Makerfabs/ESP32-S3_Parallel_TFT_3.16_ST7701S/README.md

# ESP32-S3_Parallel_TFT_3.16_ST7701S

This routine how reads the data from the QMI8658 and detects the flip to control the image switching.

## Makerfabs

[Makerfabs home page](https://www.makerfabs.com/)

[Makerfabs Wiki](https://wiki.makerfabs.com/)

## Introduce

Product Link: 

Wiki Link: [https://wiki.makerfabs.com/ESP32-S3_Parallel_TFT_3.16_ST7701S.html](https://wiki.makerfabs.com/ESP32-S3_Parallel_TFT_3.16_ST7701S.html)

The Latest ESP32-S3 3.16 inch display with 320*820 resolution, it integrated display/audio speaker/IMU(QMI8658)/RTC, to make this product ideal for applications such as IoT controlling, electronic photo frame, etc.

## Feature

- Controller: ESP32-S3
- Wireless: WiFi& Bluetooth 5.0
- LCD: 2.8", 320x820 resolution
- LCD Driver: ST7701s
- Flash: 16MB Flash
- PSRAM: 8MB
- USB: 1 * USB to UART
- Power Supply: USB Type-C 5.0V(4.0V~5.25V)
- Button: Flash button and reset button
- MicroSD: Yes
- RTC: Yes
- IMU: Yes
- Microphone input: 1CH INMP441
- Audio output: MAX98357(3.2W@4Ω)
- LVGL support: Yes
