Makerfabs/ESP32-S3_Parallel_TFT_3.16_ST7701S/examples/esp-idf/weather/README.md

Set the current chip to ESP32-S3.



Modify WIFI information.



Automatically obtain location information based on IP addresses.

The serial port output is as follows:
