Makerfabs/ESP32-S3_Parallel_TFT_3.16_ST7701S/hardware/ESP32-S3 Parallel TFT 3.16“ ST7701S v1.0.PDF

POWER | RTC

# LCD

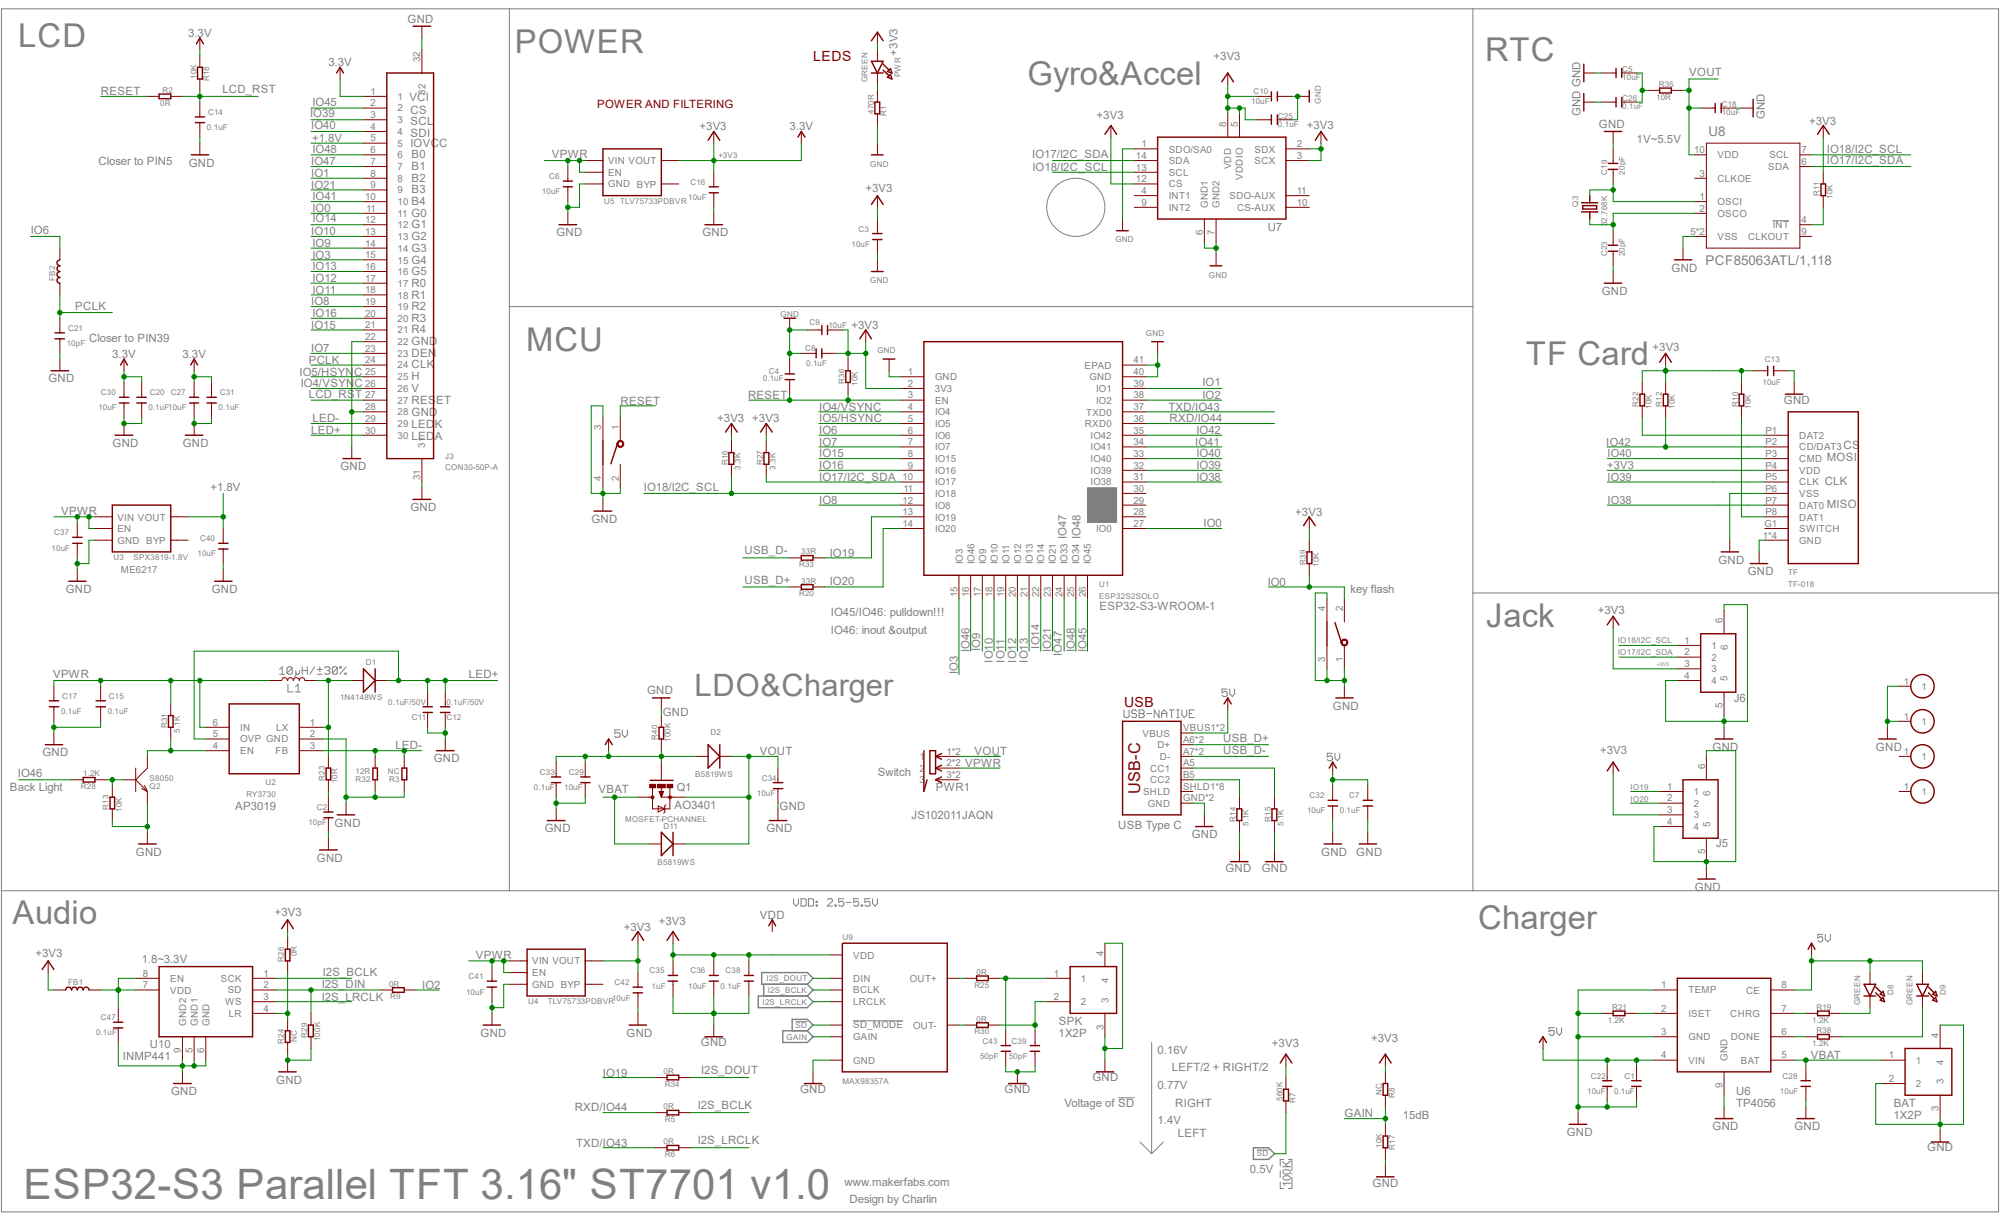
[picture p1: page 1]

www.makerfabs.com ESP32-S3 Parallel TFT 3.16" ST7701 v1.0 Design by Charlin
