Makerfabs/ESP32-S3_Parallel_TFT_3.16_ST7701S/hardware/ESP32-S3 Parallel TFT 3.16“ ST7701S v1.0.brd

## EAGLE design hardware/ESP32-S3 Parallel TFT 3.16“ ST7701S v1.0.brd (2025-10-23)

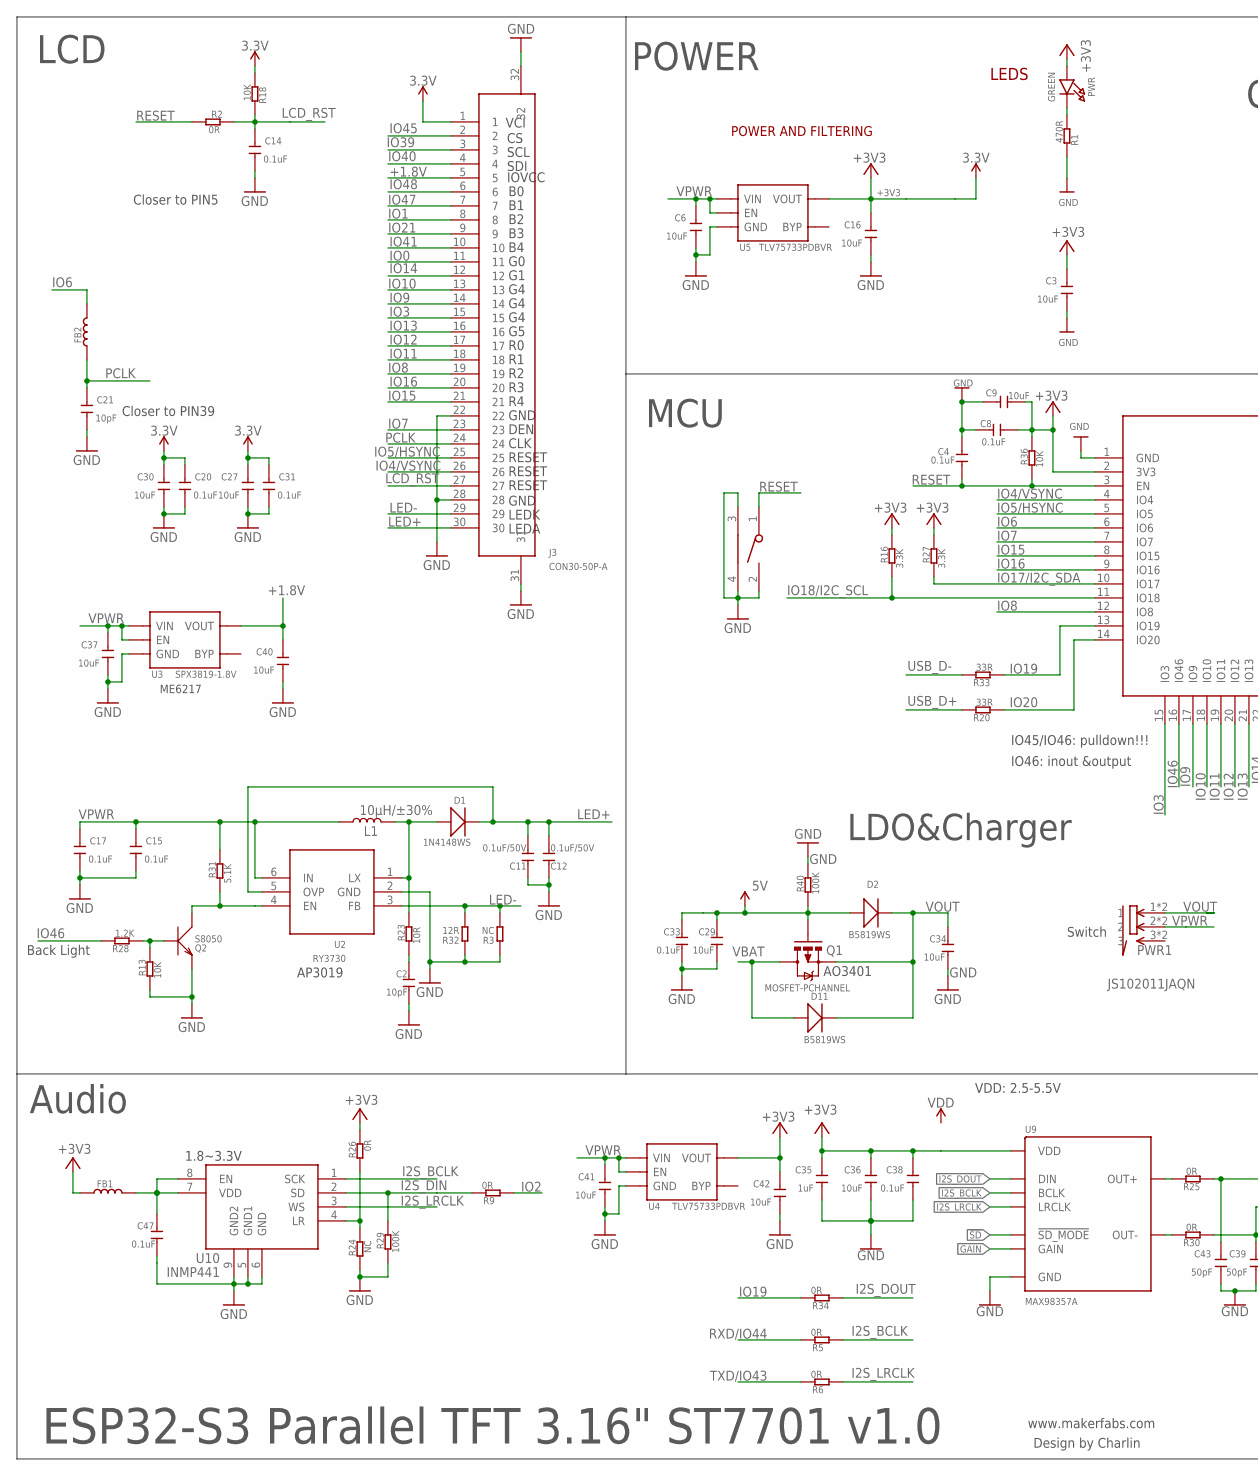
[picture p2: schematic ESP32-S3 Parallel TFT 3.16“ ST7701S v1.0.sch, part in row 1, column 1]

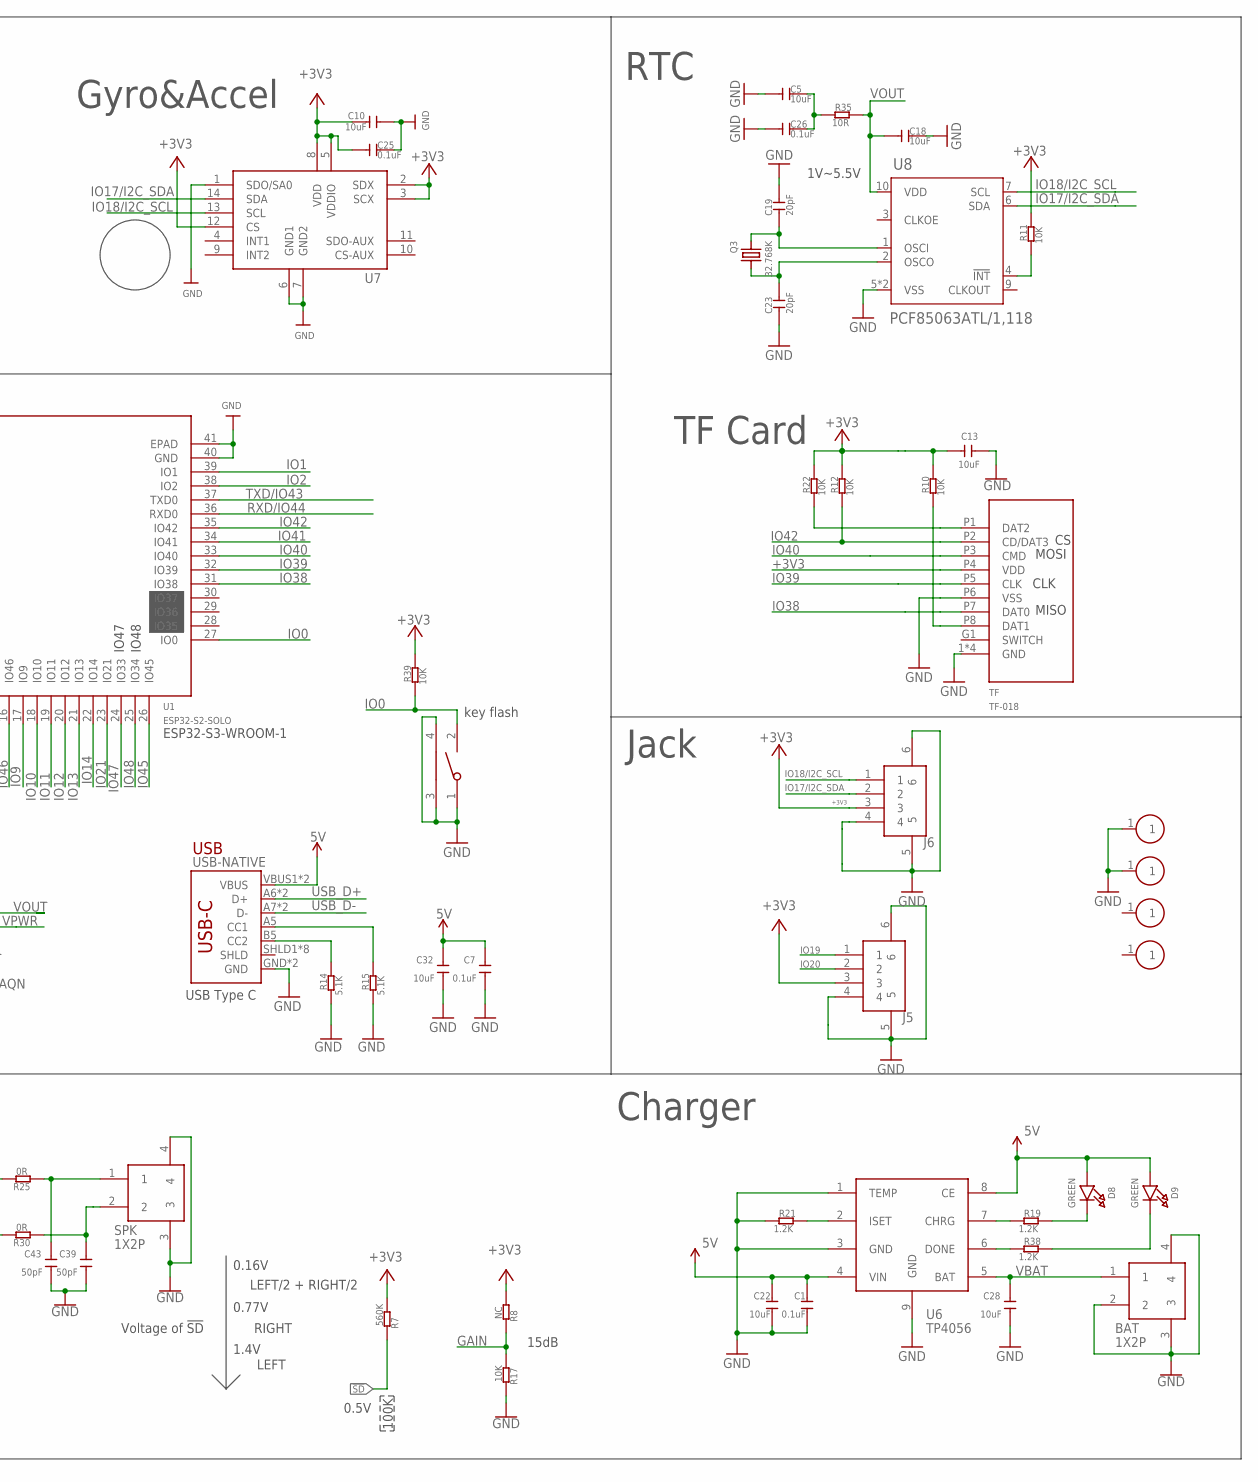
[picture p3: schematic ESP32-S3 Parallel TFT 3.16“ ST7701S v1.0.sch, part in row 1, column 2]

Parts:
BAT: 1X2P; 1X2P-SMT1.25MM
C1, C4, C7, C8, C14, C15, C17, C20, C25, C26, C31, C33, C38, C47: 0.1uF; DISCRETE_C0402
C2, C21: 10pF; DISCRETE_C0402
C3, C5, C6, C9, C10, C13, C16, C18, C22, C27, C28, C29, C30, C32, C34, C36, C37, C40, C41, C42: 10uF; DISCRETE_C0402
C11, C12: 0.1uF/50V; DISCRETE_C0603
C19, C23: 20pF; DISCRETE_C0402
C35: 1uF; DISCRETE_C0402
C39, C43: 50pF; DISCRETE_C0402
D1: 1N4148WS; SOD323
D2, D11: B5819WS; SOD323
D8, D9: GREEN; CHIPLED_0805_NOOUTLINE
FB1, FB2: L'0402'; 0402
FLASH: TS24CA; 2*4*3.5MM
J3: CON30-50P-A; SMD30-50P-1850L540W300H
J5, J6: CON4-100P-V; SMD4-100P-635L374W374H
L1: 10µH/±30%; CR54
PWR: GREEN; CHIPLED_0805_NOOUTLINE
PWR1: JS102011JAQN; SMD-6-2.5MM
Q1: MOSFET-PCHANNEL; SOT23-3
Q2: S8050; SOT23
Q3: 32.768K; XTAL3215
R1: 470R; DISCRETE_R0402
R2, R5, R6, R9, R25, R26, R30, R34: 0R; DISCRETE_R0402
R3: NC; DISCRETE_R0603
R7: 560K; DISCRETE_R0402
R8, R24: NC; DISCRETE_R0402
R10, R11, R12, R13, R17, R18, R22, R36, R39: 10K; DISCRETE_R0402
R14, R15, R31: 5.1K; DISCRETE_R0402
R16, R27: 3.3K; DISCRETE_R0402
R19, R21, R28, R38: 1.2K; DISCRETE_R0402
R20, R33: 33R; DISCRETE_R0402
R23, R35: 10R; DISCRETE_R0402
R29, R40: 100K; DISCRETE_R0402
R32: 12R; DISCRETE_R0603
RST: TS24CA; 2*4*3.5MM
S1, S2, S3, S4: CON1-A; THD1-210M-310D
SPK: 1X2P; 1X2P-SMT1.25MM
TF: TF-018
U1: ESP32­S2­SOLO; ESP32-­S2-­SOLO
U2: RY3730; SOT23-6
U3: SPX3819-1.8V; SOT23-5
U4, U5: TLV75733PDBVR; SOT23-5
U6: TP4056; SOP8-1.27P
U7: QMI8658A; LGA14-50P-300L250W86H
U8: PCF85063ATL/1,118; 10-DFN(2.6X2.6)
U9: MAX98357A; TQFN-16
U10: INMP441; SMD9-105P-472L376W98H
USB-NATIVE: USB_C5; USB-C-16P-5

Connections:
5V: C1.2, C7.2, C22.2, C29.2, C32.2, C33.2, D2.+, D8.A, D9.A, Q1.1 (G), R40.1, U6.4 (VIN), U6.8 (CE), USB-NATIVE.VBUS1 (VBUS), USB-NATIVE.VBUS2 (VBUS)
!SD: R7.2, U9.P$4 (!SD_MODE)
+1.8V: C40.2, J3.5, U3.5 (VOUT)
+3V3: C3.2, C8.1, C9.1, C10.2, C13.2, C16.2, C20.2, C25.2, C27.2, C30.2, C31.2, C35.2, C36.2, C38.2, C42.2, FB1.1, J3.1, J5.3, J6.3, PWR.A, R7.1, R8.1, R10.2, R11.2, R12.2, R16.2, R18.1, R22.2, R26.2, R27.2, R36.2, R39.2, TF.P4 (VDD), U1.2 (3V3), U4.5 (VOUT), U5.5 (VOUT), U7.2 (SDX), U7.3 (SCX), U7.5 (VDDIO), U7.8 (VDD), U7.12 (CS), U9.P$7 (VDD), U9.P$8 (VDD)
GAIN: R8.2, R17.1, U9.P$2 (GAIN)
GND: BAT.2, BAT.3, BAT.4, C1.1, C2.1, C3.1, C4.2, C5.2, C6.1, C7.1, C8.2, C9.2, C10.1, C11.1, C12.1, C13.1, C14.1, C15.1, C16.1, C17.1, C18.1, C19.1, C20.1, C21.1, C22.1, C23.2, C25.1, C26.2, C27.1, C28.1, C29.1, C30.1, C31.1, C32.1, C33.1, C34.1, C35.1, C36.1, C37.1, C38.1, C39.1, C40.1, C41.1, C42.1, C43.1, C47.1, FLASH.1, FLASH.3, FLASH.4, J3.22, J3.28, J3.31, J3.32, J5.4, J5.5, J5.6, J6.4, J6.5, J6.6, Q2.2 (E), R1.2, R3.1, R13.1, R14.1, R15.1, R17.2, R21.1, R24.1, R29.1, R32.1, R40.2, RST.2, RST.3, RST.4, S1.1, S2.1, SPK.3, SPK.4, TF.1 (GND), TF.2 (GND), TF.3 (GND), TF.4 (GND), TF.P6 (VSS), U1.1 (GND), U1.40 (GND), U1.41 (EPAD), U2.2 (GND), U3.2 (GND), U4.2 (GND), U5.2 (GND), U6.1 (TEMP), U6.3 (GND), U6.9 (GND), U7.1 (SDO/SA0), U7.6 (GND1), U7.7 (GND2), U8.5 (VSS), U8.11 (VSS), U9.P$3 (GND), U9.P$11 (GND), U9.P$15 (GND), U9.P$EP (GND), U10.5 (GND1), U10.6 (GND), U10.9 (GND2), USB-NATIVE.GND, USB-NATIVE.GND2 (GND)
I2S_BCLK: R5.1, U9.P$16 (BCLK), U10.1 (SCK)
I2S_DIN: R9.2, R29.2, U10.2 (SD)
I2S_DOUT: R34.1, U9.P$1 (DIN)
I2S_LRCLK: R6.1, U9.P$14 (LRCLK), U10.3 (WS)
IO0: FLASH.2, J3.11, R39.1, U1.27 (IO0)
IO1: J3.8, U1.39 (IO1)
IO2: R9.1, U1.38 (IO2)
IO3: J3.15, U1.15 (IO3)
IO4/VSYNC: J3.26, U1.4 (IO4)
IO5/HSYNC: J3.25, U1.5 (IO5)
IO6: FB2.2, U1.6 (IO6)
IO7: J3.23, U1.7 (IO7)
IO8: J3.19, U1.12 (IO8)
IO9: J3.14, U1.17 (IO9)
IO10: J3.13, U1.18 (IO10)
IO11: J3.18, U1.19 (IO11)
IO12: J3.17, U1.20 (IO12)
IO13: J3.16, U1.21 (IO13)
IO14: J3.12, U1.22 (IO14)
IO15: J3.21, U1.8 (IO15)
IO16: J3.20, U1.9 (IO16)
IO17/I2C_SDA: J6.2, R27.1, U1.10 (IO17), U7.14 (SDA), U8.6 (SDA)
IO18/I2C_SCL: J6.1, R16.1, U1.11 (IO18), U7.13 (SCL), U8.7 (SCL)
IO19: J5.1, R33.1, R34.2, U1.13 (IO19)
IO20: J5.2, R20.1, U1.14 (IO20)
IO21: J3.9, U1.23 (IO21)
IO38: TF.P7 (DAT0), U1.31 (IO38)
IO39: J3.3, TF.P5 (CLK), U1.32 (IO39)
IO40: J3.4, TF.P3 (CMD), U1.33 (IO40)
IO41: J3.10, U1.34 (IO41)
IO42: R12.1, TF.P2 (CD/DAT3), U1.35 (IO42)
IO45: J3.2, U1.26 (IO45)
IO46: R28.2, U1.16 (IO46)
IO47: J3.7, U1.24 (IO33)
IO48: J3.6, U1.25 (IO34)
LCD_RST: C14.2, J3.27, R2.2, R18.2
LED+: C11.2, C12.2, D1.-, J3.30, U2.5 (OVP)
LED-: J3.29, R3.2, R32.2, U2.3 (FB)
unnamed: R22.1, TF.P1 (DAT2)
unnamed: R10.1, TF.P8 (DAT1)
unnamed: C5.1, C26.1, R35.1
unnamed: C19.2, Q3.P$1 (1), U8.1 (OSCI)
unnamed: R30.2, U9.P$10 (OUT-)
unnamed: R15.2, USB-NATIVE.A5 (CC1)
unnamed: PWR.C, R1.1
unnamed: Q2.1 (B), R13.2, R28.1
unnamed: C39.2, R30.1, SPK.2
unnamed: R24.2, R26.1, U10.4 (LR)
unnamed: C47.2, FB1.2, U10.7 (VDD), U10.8 (EN)
unnamed: R11.1, U8.4 (!INT)
unnamed: C23.1, Q3.P$2 (2), U8.2 (OSCO)
unnamed: R14.2, USB-NATIVE.B5 (CC2)
unnamed: C43.2, R25.1, SPK.1
unnamed: D1.+, L1.P$2 (2), R23.2, U2.1 (LX)
unnamed: R25.2, U9.P$9 (OUT+)
unnamed: C2.2, R23.1
unnamed: R21.2, U6.2 (ISET)
unnamed: Q2.3 (C), R31.1, U2.4 (EN)
unnamed: R19.1, U6.7 (CHRG)
unnamed: R38.1, U6.6 (DONE)
unnamed: D8.C, R19.2
unnamed: D9.C, R38.2
PCLK: C21.2, FB2.1, J3.24
RESET: C4.1, R2.1, R36.1, RST.1, U1.3 (EN)
RXD/IO44: R5.2, U1.36 (RXD0)
TXD/IO43: R6.2, U1.37 (TXD0)
USB_D+: R20.2, USB-NATIVE.A6 (D+), USB-NATIVE.B6 (D+)
USB_D-: R33.2, USB-NATIVE.A7 (D-), USB-NATIVE.B7 (D-)
VBAT: BAT.1, C28.2, D11.+, Q1.3 (D), U6.5 (BAT)
VOUT: C18.2, C34.2, D2.-, D11.-, PWR1.1, PWR1.1@1 (1), Q1.2 (S), R35.2, U8.10 (VDD)
VPWR: C6.2, C15.2, C17.2, C37.2, C41.2, L1.P$1 (1), PWR1.2, PWR1.2@1 (2), R31.2, U2.6 (IN), U3.1 (VIN), U3.3 (EN), U4.1 (VIN), U4.3 (EN), U5.1 (VIN), U5.3 (EN)

Notes on the sheet:
www.makerfabs.com
Design by Charlin
LEDS
POWER AND FILTERING
ESP32-S3 Parallel TFT 3.16" ST7701 v1.0
POWER
RTC
Back Light
IO45/IO46: pulldown!!!
IO46: inout &output
USB
USB Type C
Jack
LCD
MCU
ESP32-S3-WROOM-1
IO47
IO48
Closer to PIN5
AP3019
Closer to PIN39
LDO&Charger
AO3401
VCI
LEDA
LEDK
GND
RESET
CLK
DEN
IOVCC
SDI
SCL
ME6217
key flash
TF Card
1V~5.5V
Switch
Gyro&Accel
VDD: 2.5-5.5V
0.16V
0.77V
1.4V
LEFT/2 + RIGHT/2
RIGHT
LEFT
0.5V
100K
15dB
Voltage of !SD
1.8~3.3V
MOSI
MISO
Audio
Charger

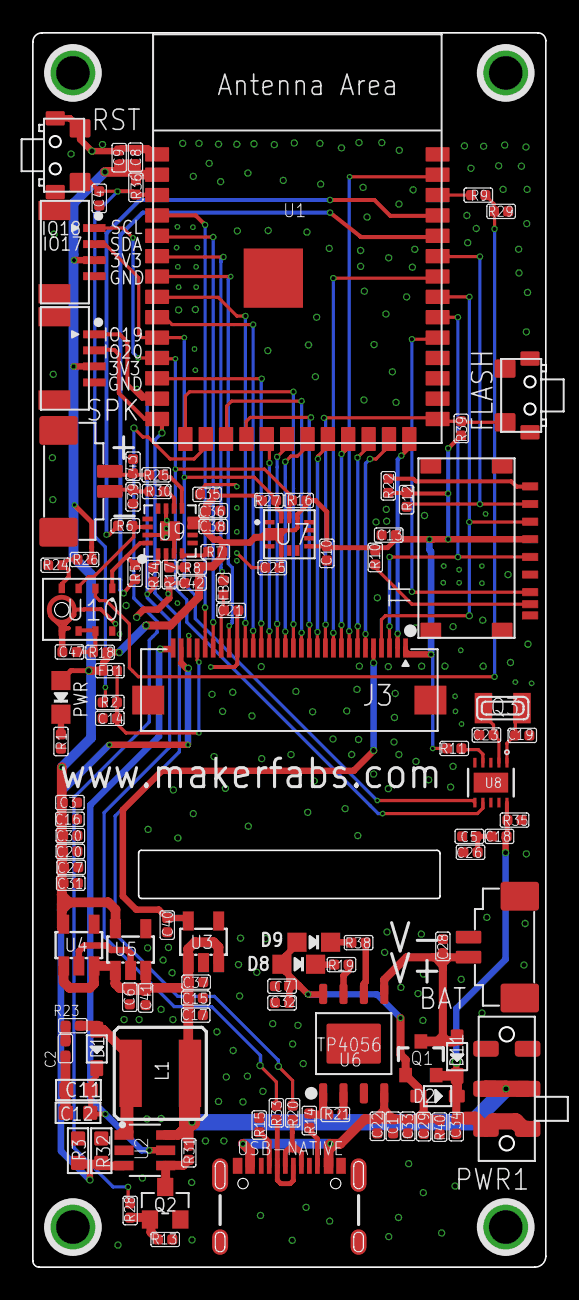
[picture p4: board ESP32-S3 Parallel TFT 3.16“ ST7701S v1.0.brd from above]

Board: 2 copper layers, 32.0 x 77.0 mm, 118 parts (1 on the bottom side), 77 nets.

Other parts of the board:
U$1: MAKERFABS_0.3
