Makerfabs/ESP32-S3_Parallel_TFT_3.16_ST7701S/(commit log)

2025-10-24 add lvgl9 example
    [partitions.csv]
2025-10-24 add weather example
    [partitions.csv]
2025-10-28 add record example
    [partitions.csv]
